mendax1234/CG2111A-Final-Project/Alex/Commands.ino

void sendStatus() {
  // Create a new packet called statusPacket
  TPacket statusPacket;

  // Set packet type to PACKET_TYPE_RESPONSE
  statusPacket.packetType = PACKET_TYPE_RESPONSE;

  // Set the command to RESP_STATUS
  statusPacket.command = RESP_STATUS;

  // Set the params array
  statusPacket.params[0] = leftForwardTicks;
  statusPacket.params[1] = rightForwardTicks;
  statusPacket.params[2] = leftReverseTicks;
  statusPacket.params[3] = rightReverseTicks;
  statusPacket.params[4] = leftForwardTicksTurns;
  statusPacket.params[5] = rightForwardTicksTurns;
  statusPacket.params[6] = leftReverseTicksTurns;
  statusPacket.params[7] = rightReverseTicksTurns;
  statusPacket.params[8] = forwardDist;
  statusPacket.params[9] = reverseDist;

  // Send the status packet using sendResponse
  sendResponse(&statusPacket);
}

void sendMessage(const char *message) {
  // Sends text messages back to the Pi. Useful
  // for debugging.

  TPacket messagePacket;
  messagePacket.packetType = PACKET_TYPE_MESSAGE;
  strncpy(messagePacket.data, message, MAX_STR_LEN);
  sendResponse(&messagePacket);
}

void dbprintf(const char *format, ...) {
  va_list args;
  char buffer[128];
  va_start(args, format);
  vsprintf(buffer, format, args);
  sendMessage(buffer);
}

void sendBadPacket() {
  // Tell the Pi that it sent us a packet with a bad
  // magic number.

  TPacket badPacket;
  badPacket.packetType = PACKET_TYPE_ERROR;
  badPacket.command = RESP_BAD_PACKET;
  sendResponse(&badPacket);
}

void sendBadChecksum() {
  // Tell the Pi that it sent us a packet with a bad
  // checksum.

  TPacket badChecksum;
  badChecksum.packetType = PACKET_TYPE_ERROR;
  badChecksum.command = RESP_BAD_CHECKSUM;
  sendResponse(&badChecksum);
}

void sendBadCommand() {
  // Tell the Pi that we don't understand its
  // command sent to us.

  TPacket badCommand;
  badCommand.packetType = PACKET_TYPE_ERROR;
  badCommand.command = RESP_BAD_COMMAND;
  sendResponse(&badCommand);
}

void sendBadResponse() {
  TPacket badResponse;
  badResponse.packetType = PACKET_TYPE_ERROR;
  badResponse.command = RESP_BAD_RESPONSE;
  sendResponse(&badResponse);
}

void sendOK() {
  TPacket okPacket;
  okPacket.packetType = PACKET_TYPE_RESPONSE;
  okPacket.command = RESP_OK;
  sendResponse(&okPacket);
}
