mendax1234/CG2111A-Final-Project/Alex/Utility.ino

/*
 * Alex's setup and run codes
 *
 */

// Clears all our counters
void clearCounters() {
  // Clear ticks
  leftForwardTicks = 0;
  rightForwardTicks = 0;
  leftReverseTicks = 0;
  rightReverseTicks = 0;

  // Clear tick turns
  leftForwardTicksTurns = 0;
  rightForwardTicksTurns = 0;
  leftReverseTicksTurns = 0;
  rightReverseTicksTurns = 0;

  leftRevs = 0;
  rightRevs = 0;
  forwardDist = 0;
  reverseDist = 0;
}

// Clears one particular counter
void clearOneCounter(int which) { clearCounters(); }
// Intialize Alex's internal states

void initializeState() { clearCounters(); }

void waitForHello() {
  int exit = 0;

  while (!exit) {
    TPacket hello;
    TResult result;

    do {
      result = readPacket(&hello);
    } while (result == PACKET_INCOMPLETE);

    if (result == PACKET_OK) {
      if (hello.packetType == PACKET_TYPE_HELLO) {
        sendOK();
        exit = 1;
      } else {
        sendBadResponse();
      }
    } else {
      if (result == PACKET_BAD) {
        sendBadPacket();
      } else {
        if (result == PACKET_CHECKSUM_BAD) {
          sendBadChecksum();
        }
      }
    }
  } // !exit
}

/*
 *
 * Alex Turning functions
 *
 */

// New function to estimate number of wheel ticks
// needed to turn an angle
unsigned long computeDeltaTicks(float ang) {
  // We will assume that angular distance moved = linear distance moved in one
  // wheel revolution. This is (probably) incorrect but simplifies calculation.
  // # of wheels revs to make one full 360 turn is alexCirc / WHEEL_CIRC
  // This is for 360 degrees. For ang degrees it will be (ang * alexCirc) / (360
  // * WHELL_CIRC) To convert to ticks, we multiply by COUNTS_PER_REV.

  unsigned long ticks =
      (unsigned long)((ang * alexCirc * COUNTS_PER_REV) / (360.0 * WHEEL_CIRC));
  return ticks;
}
