mendax1234/CG2111A-Final-Project/(commit log)

2025-03-30 Add Arduino's side control code
2025-04-01 Add Color Sensor Code
2025-04-02 Update ARM
2025-04-02 Add arm and color detection
2025-04-02 Improve Arm Code
2025-04-03 Update Motor.ino
    Fixed small error that prevented compilation
    [Motor.ino]
2025-04-09 Add LiDar
2025-04-19 Add files via upload
    Lidar client files added.
2025-04-19 Add files via upload
    Lidar server files uploaded.
2025-04-21 Add Lidar and bard metal for the servo -- Thanks Yi Cheng
2025-04-22 Add Bare Metal Code for UART Thanks @Yi Cheng!
